TuanMTruong/EFeel/boardfiles/rev1/receiver/PartsBreakdown.xlsx

Receiver/Driver
Qty | Part Name | Distributor | Distributor Number | Manufacturer | Manufacturer Number | Price | Inventory | Required | Need
1 | ATXMEGA32A4U_2 | DigiKey | ATXMEGA32A4U-AU-ND | Atmel | ATXMEGA32A4U-AU | $3.43 | 2 | 4 | 2
1 | CAPACITOR-POLAR,1000uF,20% | DigiKey | PCE3462CT-ND | Panasonic Electronic Components | EEV-FK1E102Q | $1.61 | 2 | 4 | 2
1 | CAPACITOR-POLAR,100uF,20% | DigiKey | 338-1805-1-ND | Cornell Dubilier Electronics (CDE) | AVE107M25X16T-F | $0.21 | 2 | 4 | 2
10 | CAPACITOR-SMALL,0.1uF | DigiKey | 445-1314-1-ND | TDK Corporation | C1608X7R1H104K | $0.10 | 18 | 40 | 22
1 | DIODE_FIX2 | DigiKey | 568-6518-1-ND | NXP Semiconductors | PMEG3020ER,115 | $0.48 | 1 | 4 | 3
1 | DIODE_SCHOTTKY | DigiKey | RB056L-40TE25CT-ND | Rohm Semiconductor | RB056L-40TE25 | $0.42 | 1 | 4 | 3
1 | INDUCTOR,100uH,20% | DigiKey | 732-1248-1-ND | Wurth Electronics Inc | 7447709101 | $4.42 | 2 | 4 | 2
2 | LED_FIX | DigiKey | 754-1359-1-ND | Kingbright Corp | APG1608SURKC/T | $0.23 | 8 | 8 | 0
3 | LED_FIX | DigiKey | 754-1357-1-ND | Kingbright Company LLC | APG1608CGKC/T | $0.23 | 17 | 12 | -5
1 | LM2937 | DigiKey | LM2937IMP-3.3CT-ND | National Semiconductor | LM2937IMP-3.3/NOPB | $2.23 | 2 | 4 | 2
1 | LM2576SX-5.0 | DigiKey | LM2576SX-5.0/NOPBCT-ND | Texas Instruments | LM2576SX-5.0/NOPB | $2.91 | 2 | 4 | 2
1 | MICRO-TACTILE | DigiKey | 401-1427-1-ND | C&K Components C&K Components | KMR221GLFS | $0.58 | 1 | 4 | 3
8 | MOC3063S | DigiKey | 160-2048-5-ND | Lite-On Inc | MOC3063S | $0.74 | 14 | 32 | 18
5 | RESISTOR-SMALL,1K | DigiKey | P1.0KGCT-ND | Panasonic Electronic Components | ERJ-3GEYJ102V | $0.10 | 6 | 20 | 14
16 | RESISTOR-SMALL,330 | Digikey | P330GCT-ND | Panasonic Electronic Components | ERJ-3GEYJ331V | $0.10 | 27 | 64 | 37
8 | RESISTOR-SMALL,390 | Digikey | P390GCT-ND | Panasonic Electronic Components | ERJ-3GEYJ391V | $0.10 | 8 | 32 | 24
4 | RESISTOR-SMALL,47k | DigiKey | RHM47KGCT-ND | Rohm Semiconductor | MCR03EZPJ473 | $0.10 | 6 | 16 | 10
1 | ROTARY_DIP_SWITCH | DigiKey | 563-1221-5-ND | Copal Electronics Inc | SH-7070C | $2.17 | 3 | 4 | 1
1 | SD_CARD_PINPOUT | DigiKey | 101-00581-59-1-ND | Amphenol Commercial Products | 101-00581-59 | $1.97 | 1 | 4 | 3
8 | SOT233 | DigiKey | 497-6630-1-ND | STMicroelectronics | Z0103MN 5AA4 | $0.95 | 14 | 32 | 18
1 | SWITCH-SPDT | DigiKey | EG1906-ND | E-Switch | EG1213 | $0.58 | 1 | 4 | 3
1 | XBEE_2 | DigiKey | XB24-AWI-001-ND | Digi | XB24-AWI-001 | $19.00 | 1 | 4 | 3
2 | CONN RECEPT 2MM SINGLE STR 10POS | DigiKey | S5751-10-ND | Sullins Connector Solutions | NPPN101BFCN-RC | $1.11 | 8 | 8 | 0
1 | Case | TekBots |  |  |  | $9.00 |  |  | $142.00
8 | 1x2 Male JST | DigiKey
3 | 1x4 Male JST | DigiKey
1 | 1x8 Female JST | DigiKey
 |  |  |  |  | TOTAL: | $70.20
Battery Pack and Charger
Qty | Part Name | Distributor | Distributor Number | Manufacturer | Manufacturer Number | Price
1 | 4x 18650 Batteries, Tenergy | Amazon | Link (http://www.amazon.com/Tenergy-Rechargeable-Batteries-Internal-flashlights/dp/B001CTUB8E) | Tenergy | 30006 | $30.99
1 | 18650 Battery Charger | Amazon | Link (http://www.amazon.com/Tenergy-TN270-Li-ion-Battery-Charger/dp/B004R69HO8) | Tenergy | 01270 | $12.99
1 | 18650 Battery Holder | DigiKey | BK-18650-PC8-ND | MPD (Memory Protection Devices) | BK-18650-PC8-ND | $5.71 | 2 | 2 | $11.42
 |  |  |  |  | TOTAL: | $49.69
Inverter Pack
Qty | Part Name | Distributor | Distributor Number | Manufacturer | Manufacturer Number | Price
2 | 12V Inverters | SparkFun | COM-10469 | - | - | $14.95 | 0 | 10 | $149.50
 |  |  |  |  | TOTAL: | $29.90
 |  |  |  |  | OVERALL COST | $149.79 |  |  | $302.92
