TuanMTruong/EFeel/boardfiles/rev1/receiver/receiver_1_stencil.dxf

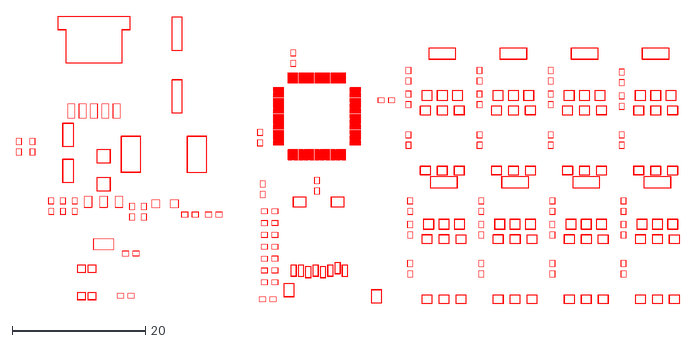
[picture p1: CAD file, 2014-01-05]
boardfiles/rev1/receiver/receiver_1_stencil.dxf
99.5 x 43.2
