TuanMTruong/EFeel/boardfiles/rev1/receiver/fixes.docx

- Large Capacitor pad size/placement needs revision
- Change Connected and RX/TX LEDs to green
- Double check all resistor values
- BURN 560Ω resistors in HELL!!!!!!!!!!!!!!!!!!!!!!!!!!!!!!!!!!!!!!!!!!!!!!!!!!!!!!!!!
- ~~Fix LED decal~~
- ~~Fix diode decal~~
