TuanMTruong/EFeel/boardfiles/rev1/receiver/receiver_1.pdf

6 | 5 | 4 | 3 | 2 | 1

D

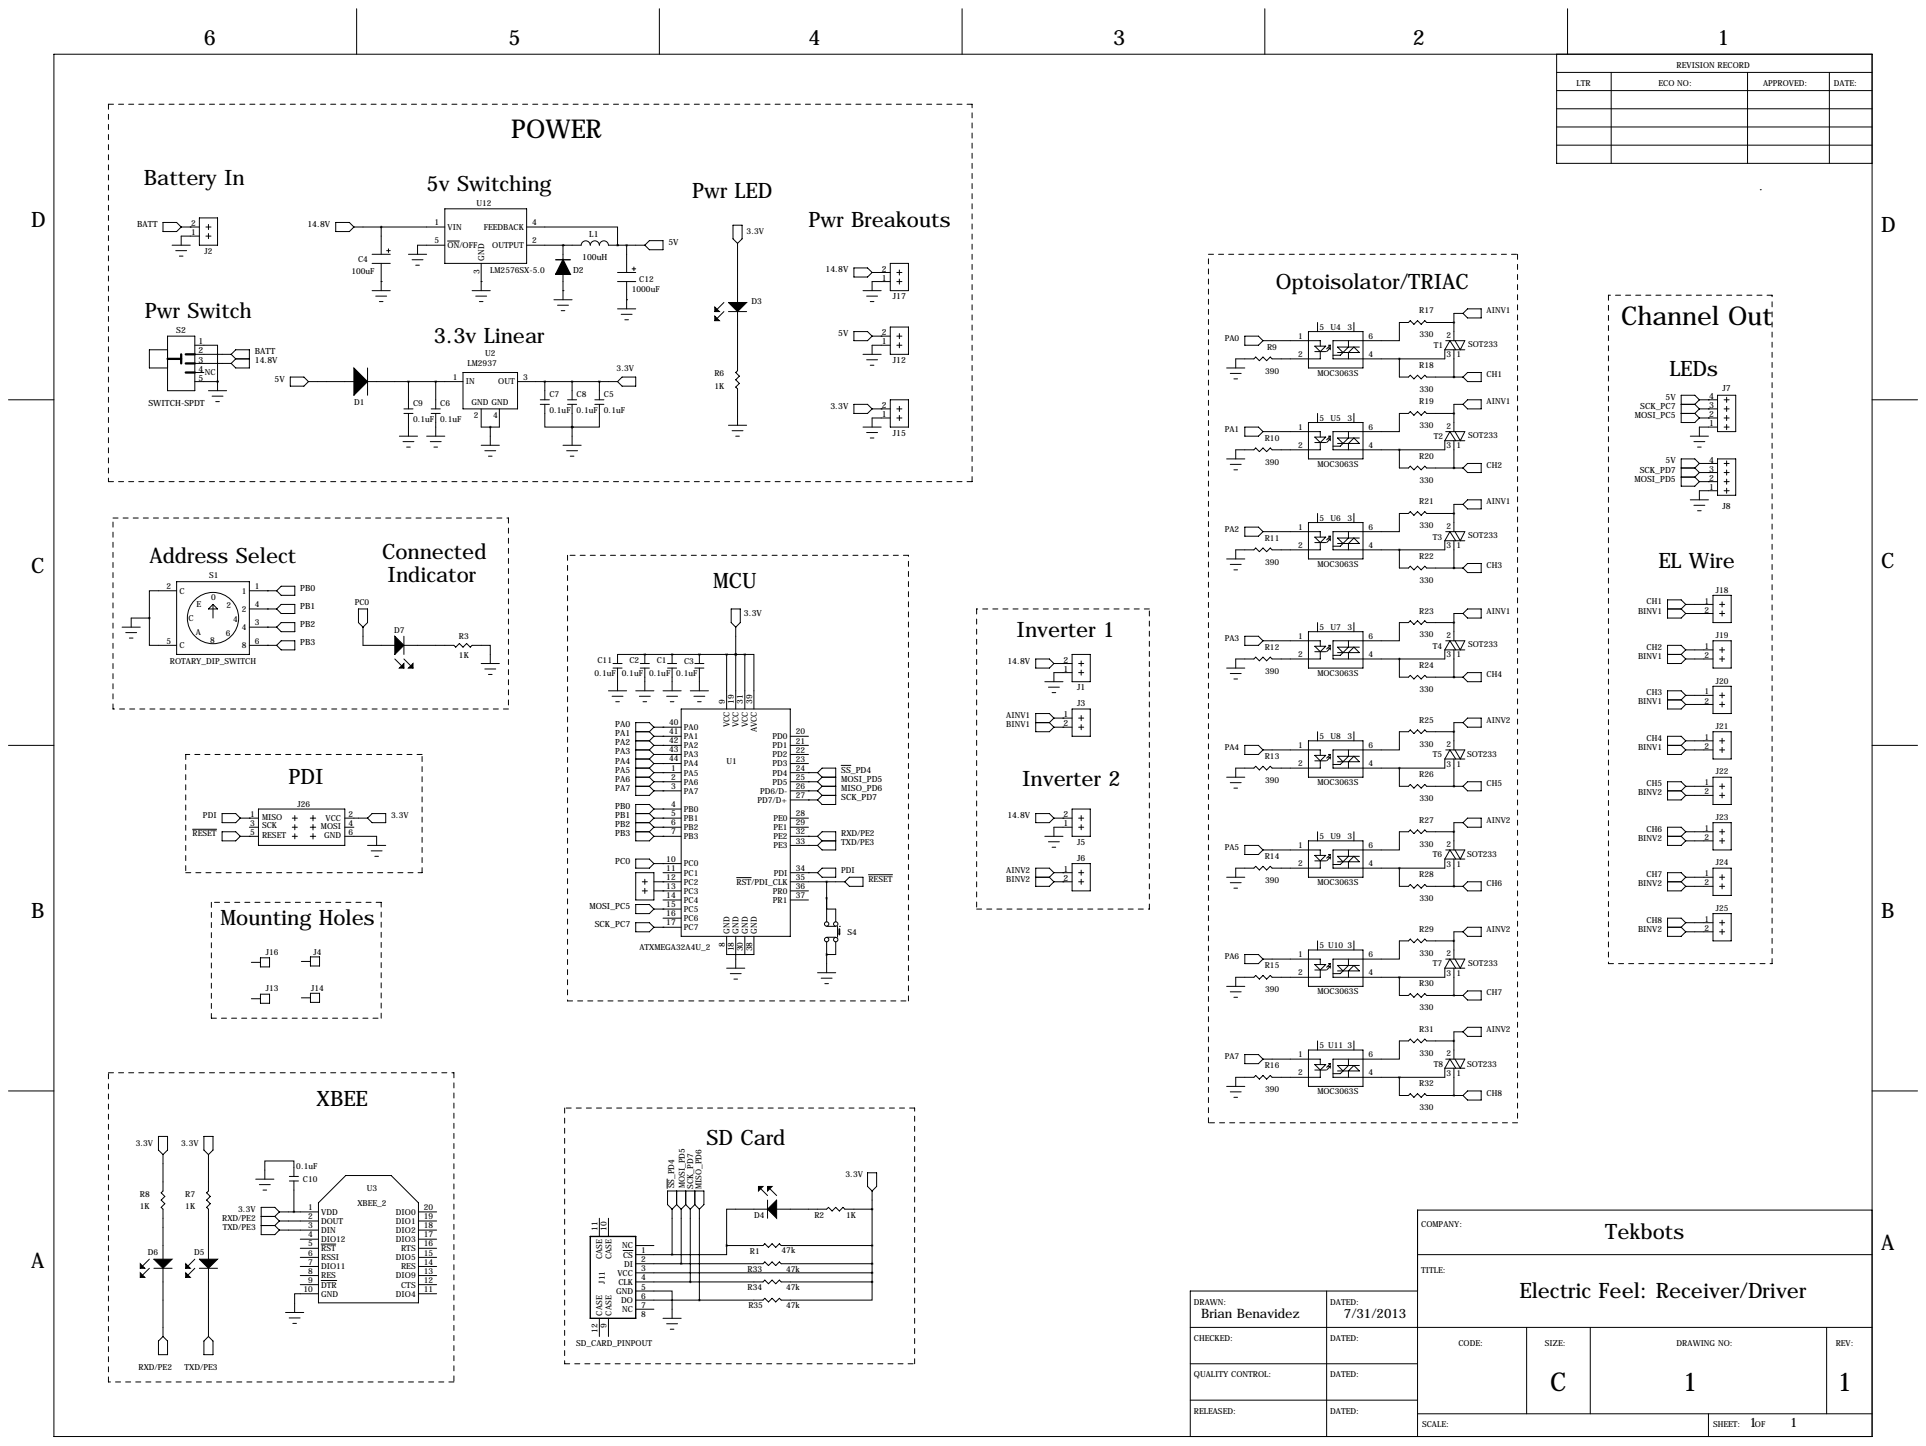
[picture p2: page 1]

REVISION RECORD

LTR | ECO NO: | APPROVED: | DATE:

Electric Feel: Receiver/Driver

CHECKED: | DATED: | CODE: | SIZE: C | DRAWING NO: 1 | REV: 1

QUALITY CONTROL: | DATED:

RELEASED: | DATED:

SCALE: | 1 1 SHEET: OF
