TuanMTruong/EFeel/boardfiles/rev1/transmitter/transmitter_1.pdf

6 | 5 | 4 | 3 | 2 | 1

D

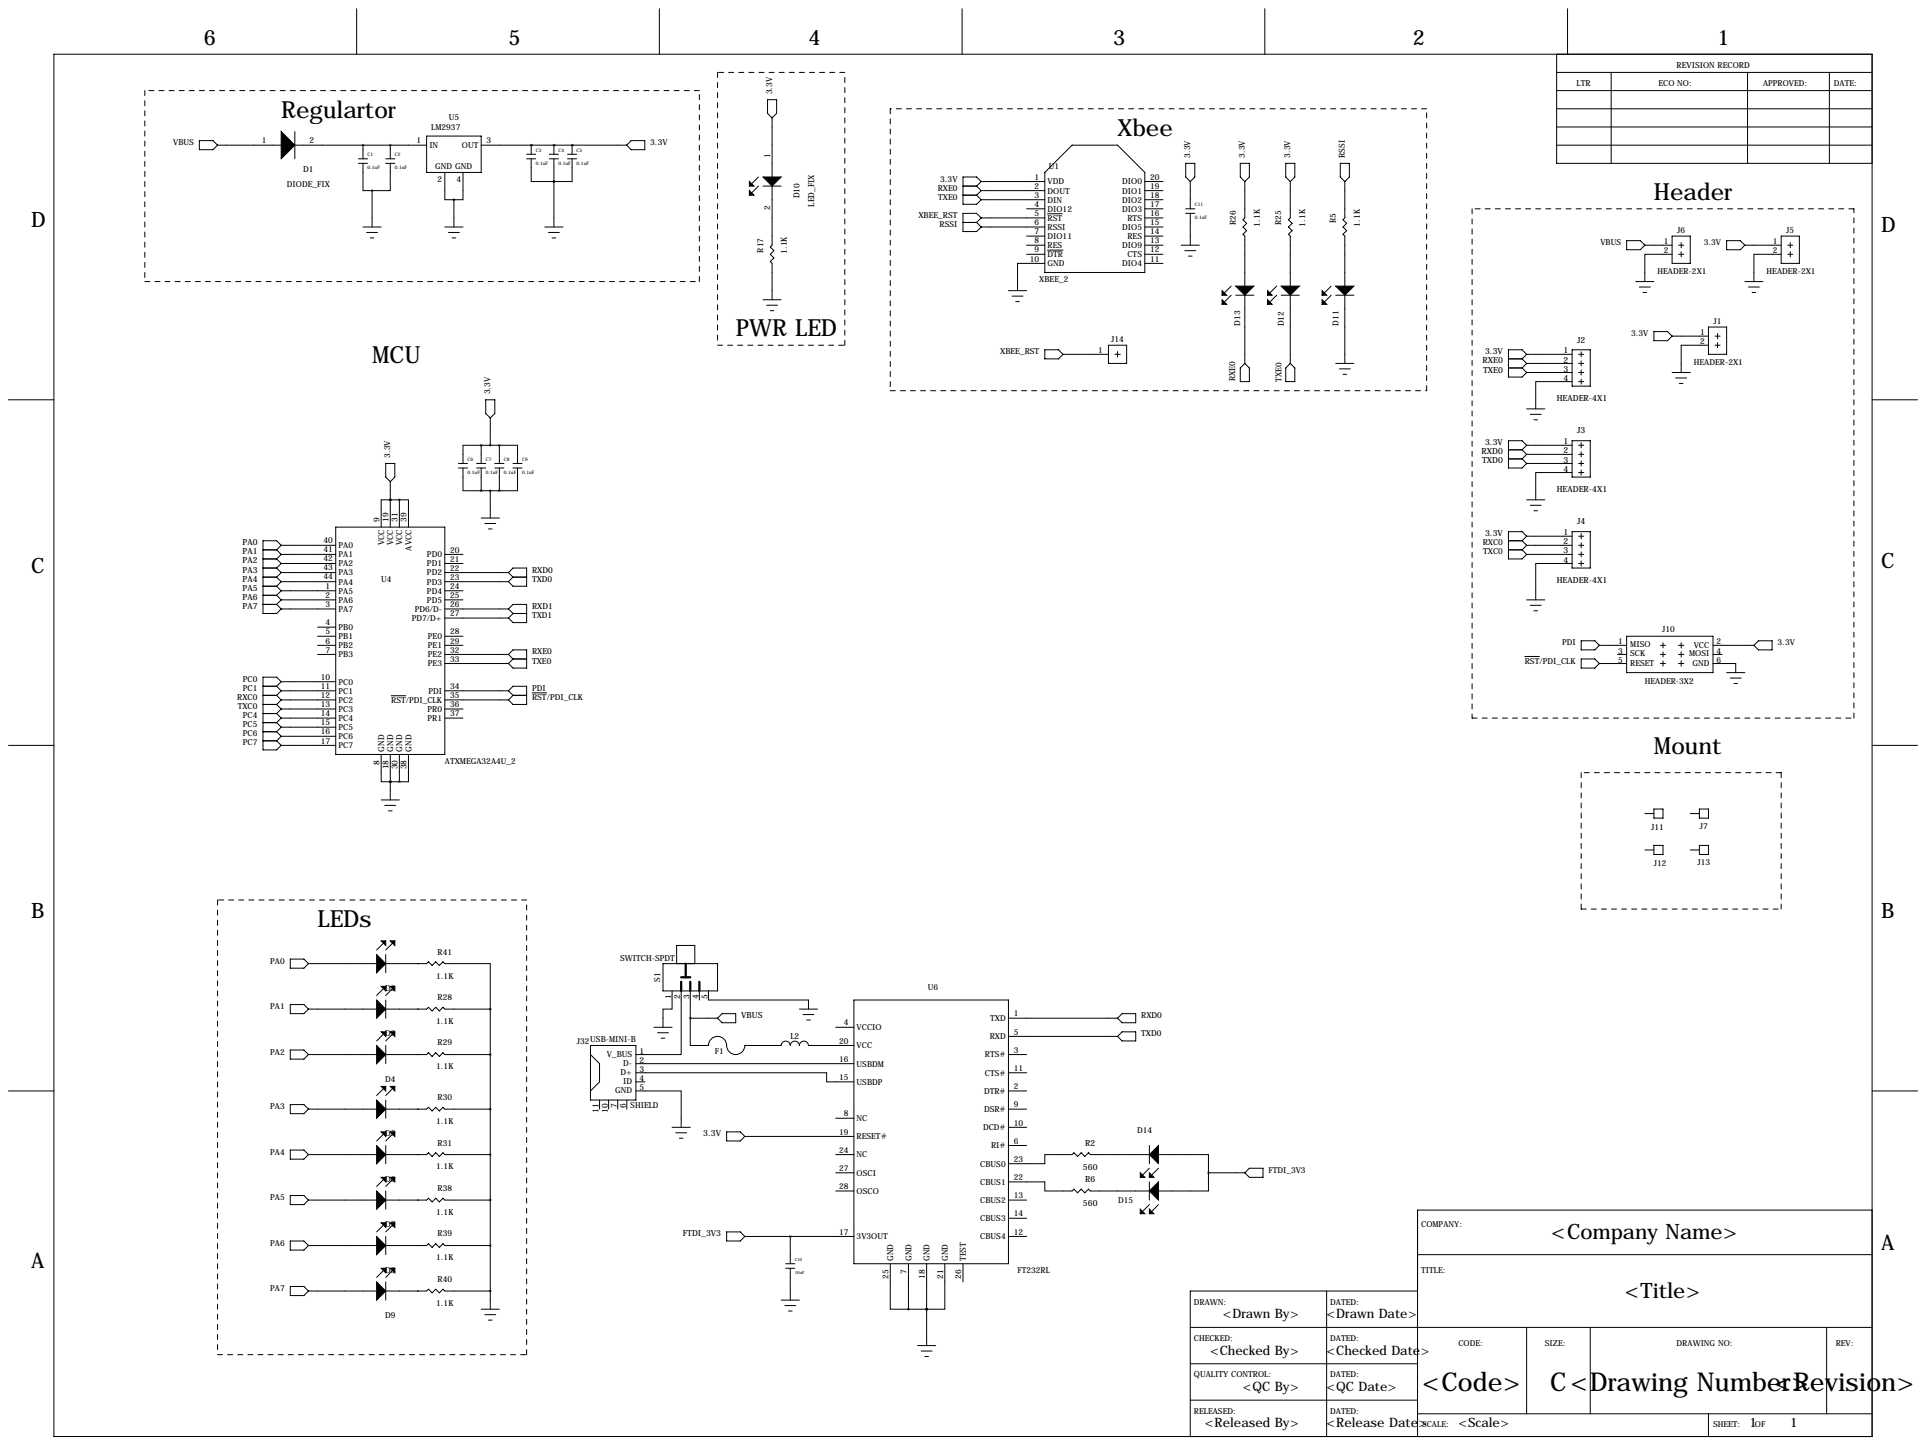
[picture p3: page 1]

CHECKED: <Checked By> | DATED: <Checked Date> | CODE: | SIZE: | DRAWING NO: | REV:

QUALITY CONTROL: <QC By> | DATED: <QC Date>

RELEASED: <Released By> | DATED:

<Scale> SCALE: | 1 1 SHEET: OF
