TuanMTruong/EFeel/boardfiles/rev0/driver/driver_0.pdf

# ABD

6

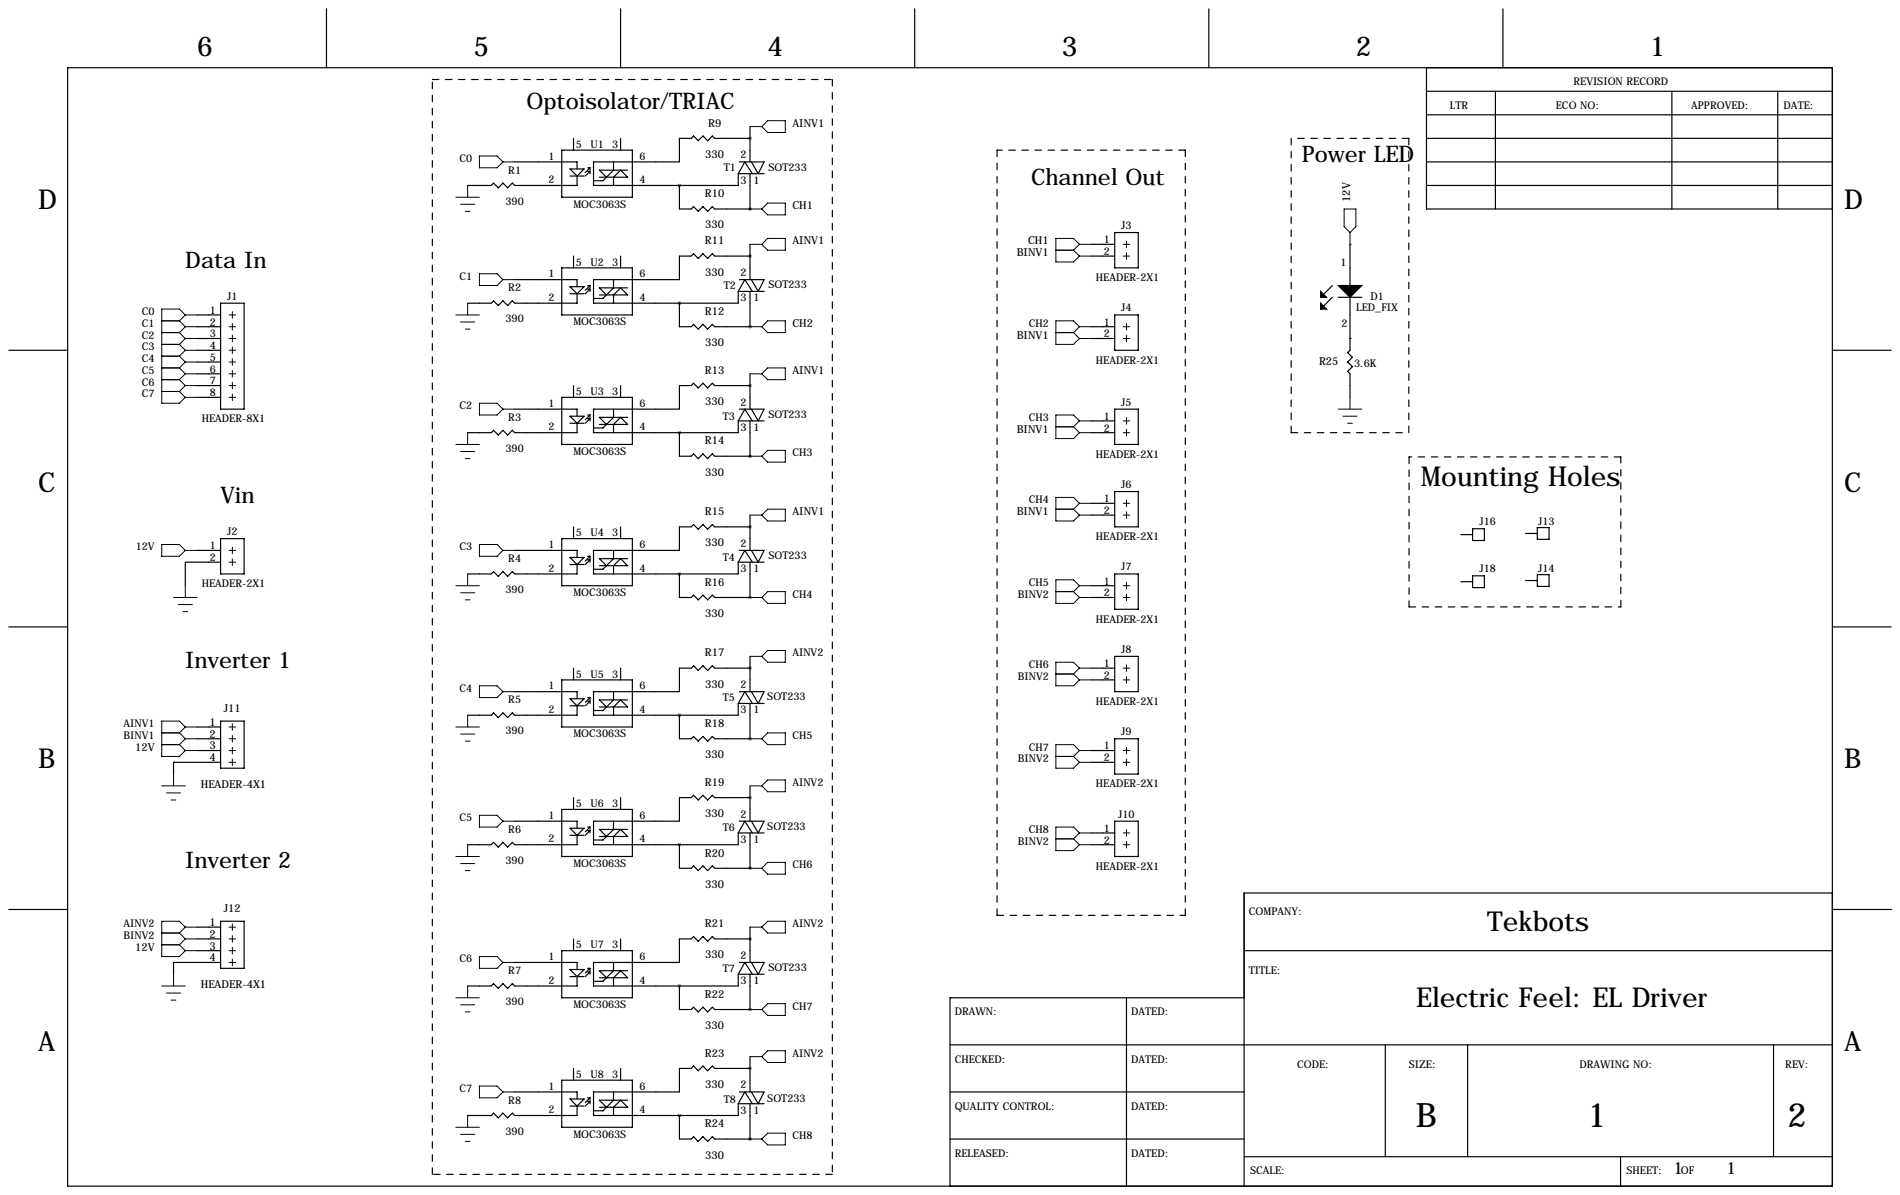
[picture p4: page 1]

REVISION RECORD

LTR | ECO NO: | APPROVED: | DATE:

Electric Feel: EL Driver

DRAWN: | DATED:
CHECKED: | DATED: | CODE: | SIZE: B | DRAWING NO: 1 | REV: 2

RELEASED: | DATED:

SCALE: | 1 1 SHEET: OF
