TuanMTruong/EFeel/boardfiles/rev0/receiver/receiver_0.pdf

6 | 5 | 4 | 3 | 2 | 1

D

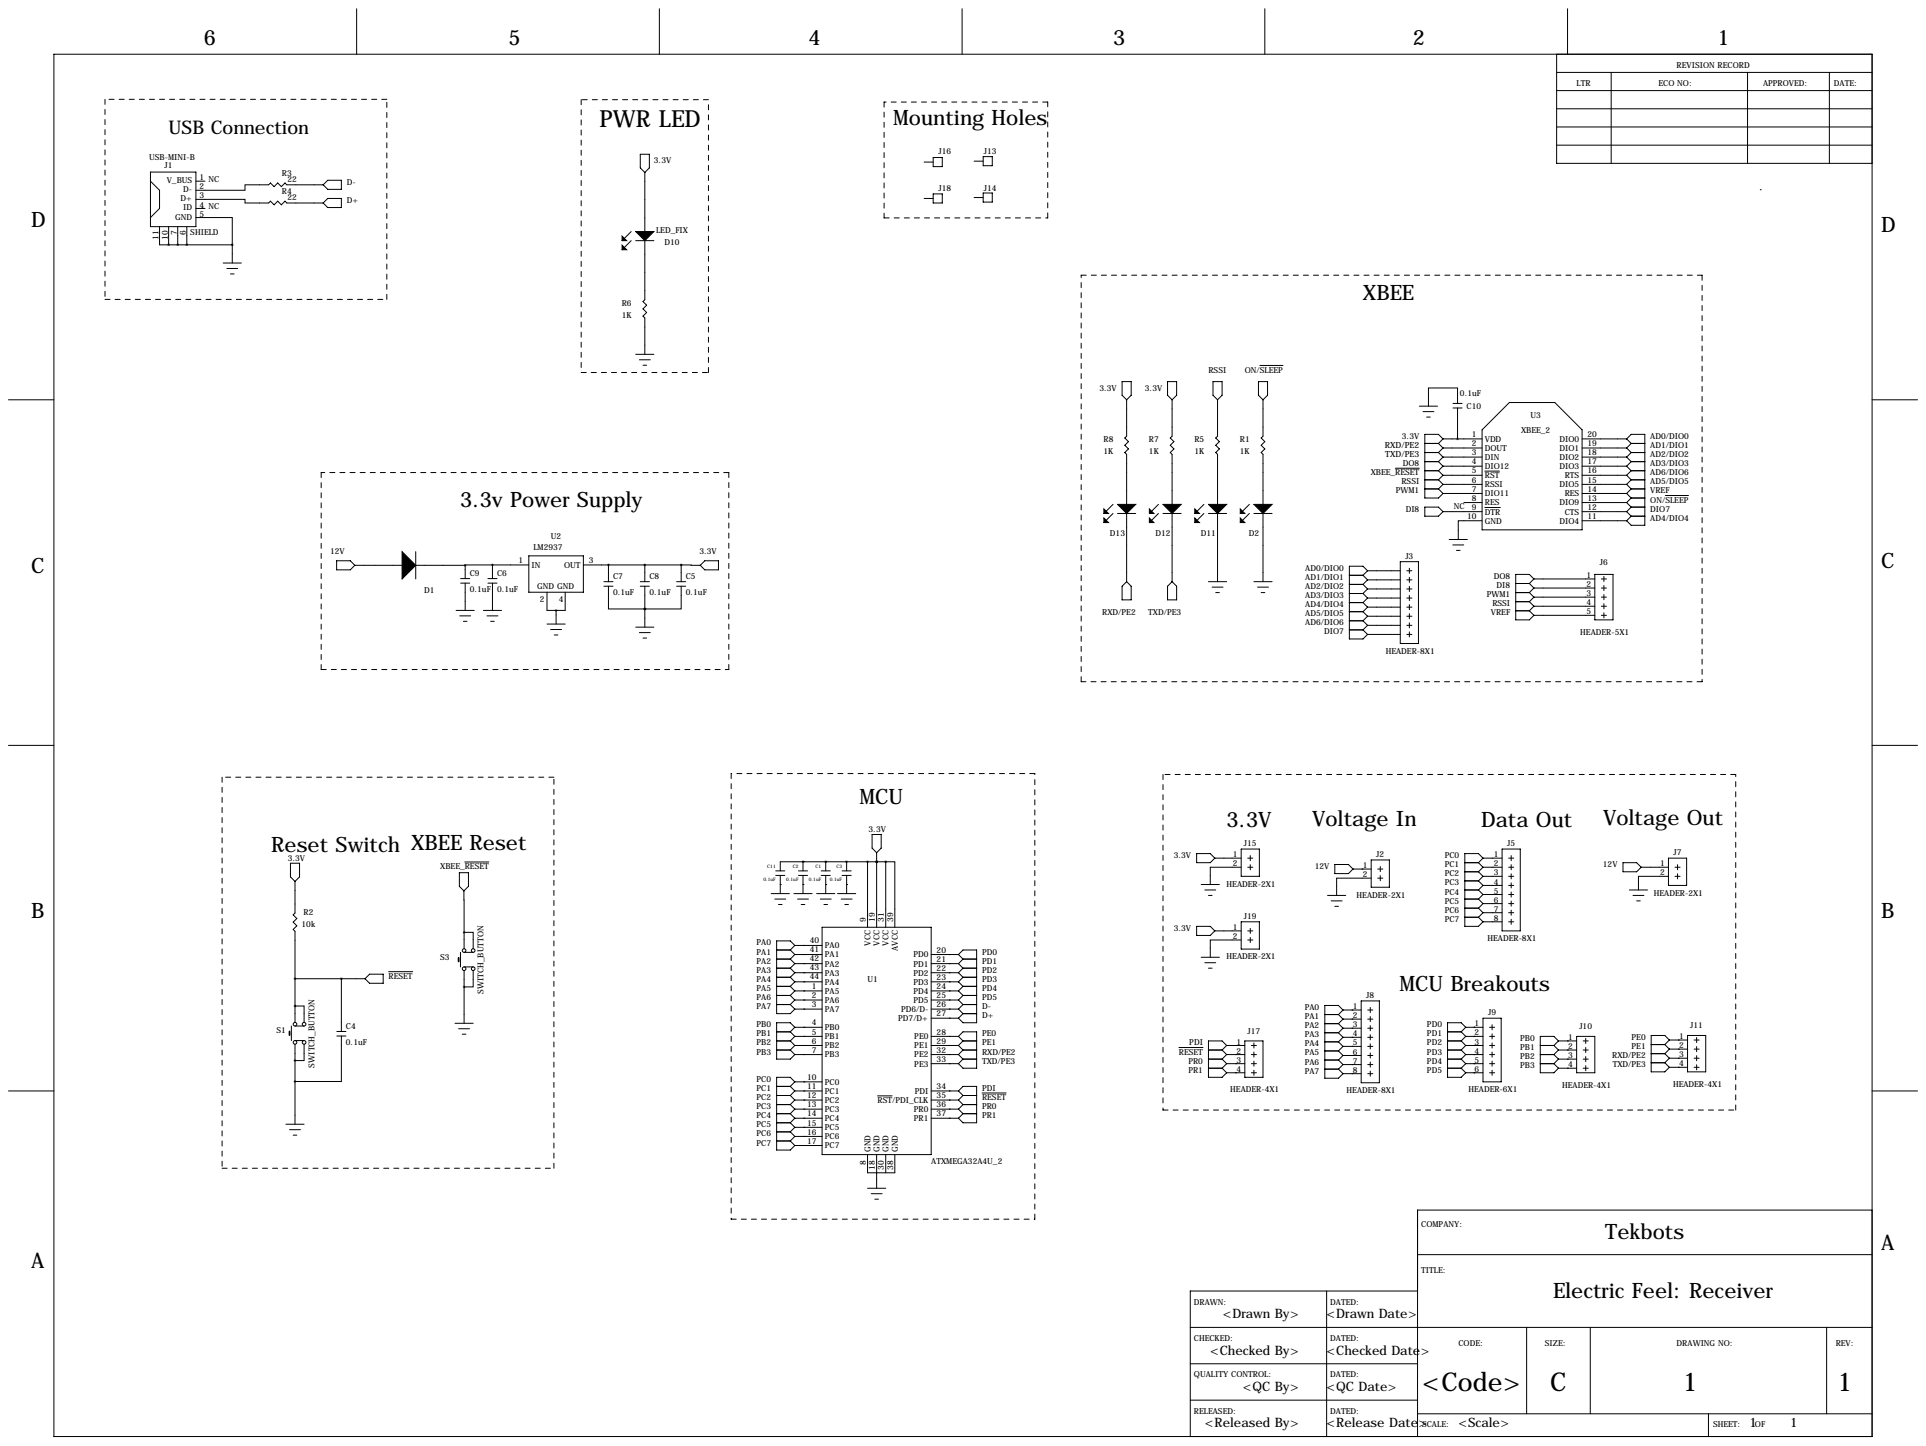
[picture p5: page 1]

REVISION RECORD

LTR | ECO NO: | APPROVED: | DATE:

Reset Switch XBEE Reset

DRAWN: <Drawn By> | DATED: <Drawn Date>
CHECKED: <Checked By> | DATED: <Checked Date> | CODE: <Code> | SIZE: C | DRAWING NO: 1 | REV: 1

QUALITY CONTROL: <QC By> | DATED: <QC Date>

RELEASED: <Released By> | DATED:

<Scale> SCALE: | 1 1 SHEET: OF
