TuanMTruong/EFeel/(list of files, drawings)

Other design files:
boardfiles/rev0/driver/driver_0.pcb
boardfiles/rev0/receiver/receiver_0.pcb
boardfiles/rev0/transmitter/transmitter_0.pcb
boardfiles/rev1/receiver/receiver_1.pcb
boardfiles/rev1/transmitter/transmitter_1.pcb
