TuanMTruong/EFeel/(commit log)

2013-11-09 added receiver and transmitter code. These were the version that got flashed into the finished boards
2013-11-10 add more comments and started code cleaning stage
2013-11-19 Increased the speed of SPI for better LED color blending
2014-01-05 added board files
    [PartsBreakdown.xlsx, driver_0.pcb, driver_0.sch, receiver_0.pcb, receiver_0.sch, receiver_1.pcb, receiver_1.sch, receiver_1_stencil.dxf]
